TomasBrigido/sensor-de-niveles-de-sonido-pic16f887/(list of files, drawings)

Other design files:
src/TPI_Grupo14.pdsprj
