TomasBrigido/sensor-de-niveles-de-sonido-pic16f887/(commit log)

2026-08-05 archivos del proyecto
    [TPI_Grupo14.pdsprj]
2026-08-05 cambio estructura de proyecto
    [TPI_Grupo14.pdsprj]
